Anbu-00001/ConcriSense/ConcreSense_Embedded_Programming_Report.docx

# EMBEDDED PROGRAMMING PROJECT REPORT

Project: ConcreSense: IoT-Based Concrete Quality Verification System
Name: Anbuchelvan Ganesan
Roll No: 24CS0059
Class: CSE - A
Subject: Embedded Programming

# 1. Abstract

ConcreSense is a portable ESP32-based embedded IoT system designed to verify fresh concrete quality directly at construction sites. The device combines a load cell, capacitive moisture sensor, DS18B20 temperature sensor and MPU6050 vibration sensor to capture multiple physical characteristics of a concrete sample. Sensor fusion data is processed using a TinyML model deployed on the ESP32 through Edge Impulse to classify the concrete as GOOD, MARGINAL or REJECT. A NEO-6M GPS module tags every test with location and timestamp, while Wi-Fi/MQTT uploads the results to a cloud dashboard for monitoring, reporting and audit. The proposed solution reduces dependence on laboratory testing, helps detect material fraud, and provides affordable real-time quality verification for civil engineering projects.

## Keywords

ESP32, TinyML, Edge Impulse, Concrete Quality, IoT, Sensor Fusion, GPS, MQTT, Embedded Systems, Construction Monitoring

# 2. Physical Design

The system is built around an ESP32 development board powered by a rechargeable 3.7V Li-ion battery with charging circuitry. A load cell with HX711 amplifier measures load/slump characteristics, a capacitive moisture sensor estimates water content, a DS18B20 measures temperature, and an MPU6050 captures vibration and motion. A NEO-6M GPS module provides location data while a 0.96-inch SSD1306 OLED displays the classification result. The ESP32 communicates with a cloud dashboard through Wi-Fi using MQTT. All modules are integrated inside a portable IP54 enclosure suitable for field use.

## Hardware Architecture

Component | Purpose
ESP32 | Main controller and TinyML inference
HX711 + Load Cell | Concrete load/slump sensing
Capacitive Moisture Sensor | Water content estimation
DS18B20 | Temperature measurement
MPU6050 | Vibration/motion sensing
NEO-6M GPS | Location and timestamp
SSD1306 OLED | Display result
Wi-Fi/MQTT | Cloud communication

# 3. Logical Design

1. Initialize ESP32 and all sensors.
2. Acquire sensor readings from load cell, moisture, temperature and MPU6050.
3. Perform preprocessing and feature extraction.
4. Execute TinyML inference using the Edge Impulse model.
5. Classify the sample as GOOD, MARGINAL or REJECT.
6. Read GPS coordinates and timestamp.
7. Display the result on OLED.
8. Publish JSON data to the cloud dashboard via MQTT.
9. Store test history for monitoring and reporting.

# 4. Circuit Design

The ESP32 acts as the central controller. HX711 interfaces with the load cell using digital data and clock pins. The moisture sensor connects to an ADC pin. DS18B20 communicates through the OneWire interface with a pull-up resistor. MPU6050 communicates over I2C (SDA/SCL). The GPS module uses UART communication, while the OLED display shares the I2C bus. Power is supplied from the Li-ion battery through a charging/protection module to the ESP32 and peripherals. All modules share a common ground for reliable operation.

## Suggested GPIO Connections

Module | ESP32 Interface | Example Pins
HX711 | Digital | GPIO18, GPIO19
Moisture Sensor | ADC | GPIO34
DS18B20 | OneWire | GPIO4
MPU6050 | I2C | GPIO21(SDA), GPIO22(SCL)
NEO-6M GPS | UART | GPIO16(RX), GPIO17(TX)
OLED SSD1306 | I2C | GPIO21, GPIO22

Note: GPIO assignments may be modified depending on the ESP32 development board used.
