Anbu-00001/ConcriSense/ConcreSense_Review0 (3).pptx

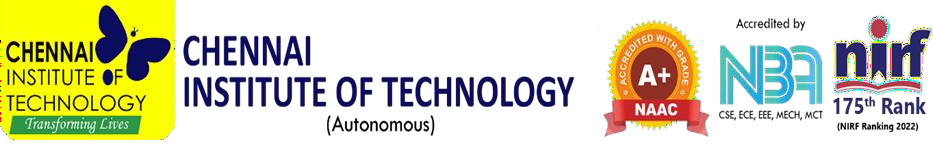
[picture p1: figure]

Department of Computer Science and Engineering
EMBEDDED PROGRAMMING

ConcreSense: IoT-Based Concrete Quality Verification System

Presentation by: [Student Name(s)] | [Roll No.] | [Year & Section]

Supervisor: Dr. [Faculty Name], Dept. of CSE

EMBEDDED PROGRAMMING PROJECT-ZEROTH REVIEW

## CONTENTS

I. Introduction
II. Problem Statement
III. Project Description
IV. Aim and Scope of the Proposed work
V. Literature Survey
VI. Hardware Component
VII. Block Diagram Design
VIII. Project Planning

## Introduction

- Background
- Concrete is the most widely used construction material worldwide, forming the backbone of infrastructure projects ranging from bridges and dams to residential buildings.
- The Problem
- Material fraud involving substandard or adulterated concrete is a persistent challenge in construction, leading to structural failures and safety hazards. Traditional quality testing methods are lab-based, slow, and easy to manipulate.
- Our Solution: ConcreSense
- ConcreSense is a low-cost, portable IoT device powered by the ESP32 microcontroller. It uses an array of sensors and an on-device TinyML model to instantly assess concrete quality at the construction site, GPS-tag each test, and push results to a secure cloud dashboard — making material fraud detectable in real time.
- Key Technologies
- ESP32 Microcontroller | TinyML (Edge Impulse SDK) | Sensor Fusion | NEO-6M GPS | MQTT / Wi-Fi | Cloud Dashboard

## Problem Statement

- Construction quality fraud and the absence of real-time concrete verification pose serious risks to structural safety and public infrastructure. Existing solutions fail to provide immediate, tamper-proof, on-site testing at low cost.
- Key Challenges
- Delayed Testing: Conventional cube strength tests take 7 to 28 days in a laboratory, providing no real-time feedback during active pours.
- Material Fraud: Substandard concrete — with incorrect water-cement ratios, added impurities, or inadequate mixing — is routinely supplied without detection.
- No Location Traceability: Current inspection records lack GPS-verified timestamps, making it impossible to audit which batch was used at which site location.
- High Equipment Cost: Professional concrete analyzers cost ₹50,000 to ₹5,00,000, making them inaccessible to small and mid-scale contractors.
- Need
- An affordable, embedded IoT system capable of real-time concrete quality classification, GPS tagging, and secure cloud reporting — deployable by any site engineer without laboratory infrastructure.

## Project Description

- ConcreSense is a portable, battery-powered IoT device that performs instant on-site concrete quality verification using sensor fusion and TinyML inference — without any laboratory infrastructure.
- How It Works
- Sense: Multi-sensor array (load cell, moisture, temperature, accelerometer) captures fresh concrete properties in under 60 seconds.
- Classify: On-device TinyML model (trained via Edge Impulse) classifies the batch as GOOD, MARGINAL, or REJECT based on IS 456:2000 parameters.
- Tag: NEO-6M GPS module appends geographic coordinates and UTC timestamp to every test result.
- Report: Results are shown on an OLED display and transmitted via Wi-Fi (MQTT) to a secure cloud dashboard with real-time alerts, test history maps, and PDF export.
- Target Cost: Under ₹5,000 per unit | Target Classification Accuracy: ≥ 90%

## Aim and Scope of the Proposed work

- Aim
- To design, develop, and validate an embedded IoT system (ConcreSense) that performs real-time, on-site concrete quality verification using TinyML on the ESP32 and delivers GPS-tagged results to a secure cloud dashboard to detect and prevent material fraud in construction.
- Scope of Work
- Hardware: Integrate load cell, capacitive moisture, temperature, and vibration sensors with ESP32 and GPS module into a portable, IP-rated enclosure.
- Machine Learning: Train and deploy a TinyML classification model on the ESP32 using Edge Impulse, targeting ≥ 90% accuracy across Good, Marginal, and Reject categories.
- Cloud Integration: Build an MQTT-connected dashboard for real-time alerts, geo-mapped test history, and report export; compliant with IS 456:2000 quality benchmarks.
- Future Scope
- Ultrasonic pulse velocity testing for hardened concrete | Blockchain-backed immutable audit trail | Multi-site fleet management portal

## Literature Survey

- [1] Nasr et al. (2021) — CNN for Concrete Crack Detection
- Achieved ~92% accuracy detecting cracks using image-based CNNs. Limitation: only addresses hardened concrete defects; cannot assess fresh concrete quality or fraud.
- [2] Cha et al. (2019) — Deep Learning for Structural Defect Detection
- Demonstrated TinyML feasibility on ARM Cortex-M edge devices for structural monitoring. Validated that lightweight neural networks can run inference on microcontrollers at low power.
- [3] ESP32-Based IoT for Construction Monitoring (2022)
- Real-time temperature and humidity monitoring during concrete curing using ESP32. Useful precedent but limited to environmental parameters; no quality classification or fraud detection.
- [4] Edge Impulse / TinyML Research (2023)
- Sensor-fusion TinyML models for construction material classification on edge devices achieved 88% accuracy. Confirms viability of on-device inference without cloud dependency.
- Research Gap
- No existing system combines multi-sensor fusion, on-device TinyML classification, GPS traceability, and a secure cloud dashboard in a single affordable device for fresh concrete quality verification at the pour site.

## Hardware Component

- ESP32 Development Board — Main microcontroller; dual-core 240 MHz, built-in Wi-Fi and Bluetooth, 520 KB SRAM for TinyML inference.
- Load Cell + HX711 Amplifier — Measures compressive force and slump consistency of fresh concrete mix.
- Capacitive Moisture Sensor (FC-28) — Detects water-cement ratio anomalies (excess water weakens concrete strength).
- DS18B20 Temperature Sensor — Monitors concrete mix temperature; extreme temps affect curing and final strength.
- MPU-6050 (Accelerometer / Gyroscope) — Captures vibration signatures during mixing to detect segregation or air voids.
- NEO-6M GPS Module — Geo-tags every test with latitude, longitude, and UTC timestamp for audit traceability.
- OLED Display (SSD1306, 0.96”) — On-device display of classification result (GOOD / MARGINAL / REJECT) for field engineer.
- Li-Ion Battery Pack (3.7 V, 5000 mAh) + TP4056 Charger — Enables full-day field operation without mains power.
- 3D-Printed IP54-Rated Enclosure — Dust and splash resistant housing designed for rugged construction site conditions.

## Block Diagram Design

- The ConcreSense system follows a three-layer IoT architecture — Sensing, Processing, and Communication — all hosted on the ESP32.
- Layer 1 — Sensor Layer (Inputs)
- Load Cell (HX711) → ESP32 GPIO | Moisture Sensor → ESP32 ADC | DS18B20 → OneWire Bus | MPU-6050 → I²C Bus | NEO-6M GPS → UART
- Layer 2 — Processing Layer (ESP32 Core)
- Raw sensor data is pre-processed (normalization, feature extraction) by ESP32 Core 0. Core 1 runs the TinyML inference engine (Edge Impulse SDK) to classify the batch as GOOD, MARGINAL, or REJECT. GPS coordinates and timestamp are appended to the result payload.
- Layer 3 — Communication and Display Layer (Outputs)
- OLED Display: Immediate on-screen result for field engineer. Wi-Fi / MQTT: JSON payload transmitted to cloud broker (e.g., HiveMQ / AWS IoT). Dashboard: React-based web portal renders live map, result history, trend charts, and PDF export. Alert System: Automated email / SMS alert on REJECT classification.
- Full cycle — sensor read to cloud update: < 5 seconds

## Project Planning

- The project is planned over 12 weeks from component procurement to final demonstration and documentation.
- Week 1–2: Component Procurement and Hardware Setup
- Source ESP32, sensors, GPS module, display, and enclosure materials. Verify component specifications and set up development environment (Arduino IDE / PlatformIO, Edge Impulse).
- Week 3–4: Sensor Integration and Data Acquisition
- Interface all sensors with ESP32. Validate data readings against known concrete mixes. Build data logging pipeline for ML dataset collection.
- Week 5–6: Dataset Collection and Labelling
- Prepare concrete batches of varying quality (correct mix, excess water, sand substitution). Collect 200+ labelled sensor readings across GOOD, MARGINAL, and REJECT classes.
- Week 7–8: TinyML Model Training and Deployment
- Train classification model on Edge Impulse. Optimize for ESP32 SRAM constraints. Deploy quantized model to ESP32 firmware and test inference accuracy on holdout data.
- Week 9–10: GPS, Wi-Fi, Cloud Dashboard Integration
- Integrate GPS module, implement MQTT transmission, and build cloud dashboard with map view, history log, alerts, and PDF export.
- Week 11: Field Testing and Calibration
- Conduct field trials at a simulated construction site. Calibrate sensors, validate GPS accuracy, and stress-test the enclosure. Cross-check results against IS 456:2000 benchmarks.
- Week 12: Documentation and Final Review Presentation
- Complete project report, circuit diagrams, and code documentation. Prepare and deliver final demonstration to review panel.
