Anbu-00001/ConcriSense/tinyml_model/eval_output/confusion_matrix.png

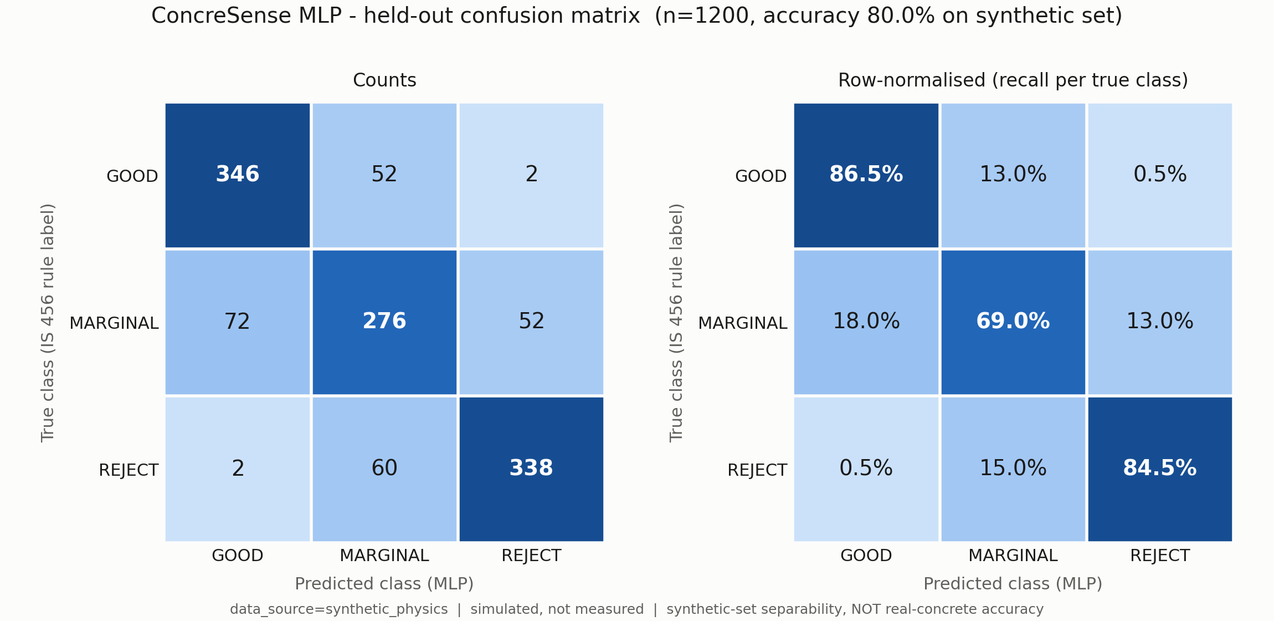
tinyml_model/eval_output/confusion_matrix.png
