Anbu-00001/ConcriSense/firmware/concresense/src/config.h

// ConcreSense — central hardware configuration
//
// Board verified over USB on 2026-08-04:
//   ESP32-D0WD-V3 rev v3.1 | dual core 240MHz | 4MB flash | no PSRAM
//   MAC c0:cd:d6:ce:4a:50  | "Vref calibration in eFuse" present
//
// The eFuse Vref matters: it lets analogReadMilliVolts() return a properly
// calibrated voltage instead of assuming a nominal 1100mV reference that can
// really be anywhere from 1000-1200mV part to part.
//
// No PSRAM matters too: GPIO16/17 are only free for UART2 because this is a
// WROOM. On a WROVER those pins belong to the PSRAM and the GPS dies silently.

#pragma once
#include <Arduino.h>

// ---------------------------------------------------------------- identity
#define DEVICE_ID "CONCRESENSE_ESP32_001"
#define FW_VERSION "0.5.0-phase5"
#define COMPLIANCE_STANDARD "IS 456:2000"

// Submission identity. Kept here rather than inline in the sketch so it appears
// in exactly one place -- it is printed on the serial banner and the OLED
// splash, and duplicating string literals across both is how they drift apart.
#define STUDENT_NAME "Anbuchelvan"
#define STUDENT_SECTION "CSE A"
#define STUDENT_ROLL "24CS0059"

// ------------------------------------------------------------------- pins
// I2C bus 0 — shared by SSD1306 OLED and MPU-6050 (distinct addresses)
#define PIN_I2C_SDA 21
#define PIN_I2C_SCL 22
#define I2C_FREQ_HZ 400000UL  // 400kHz: the 128x64 frame push is ~1KB, and at
                              // 100kHz it would stall IMU sampling badly

#define ADDR_SSD1306 0x3C
#define ADDR_MPU6050 0x68  // 0x69 if AD0 is strapped high

// Capacitive soil-moisture sensor v1.2 -> ADC1 (input-only pin, no pull-ups)
//
// NOTE: the project docs call this an "FC-28". That is wrong and it matters.
// FC-28 is the RESISTIVE two-prong module; it measures ionic conductivity,
// corrodes within minutes in cement pore solution, and is NOT described by the
// Lichtenecker dielectric model the docs cite. Use the capacitive v1.2 board.
#define PIN_MOISTURE_AOUT 34

// HX711 load cell amplifier (bit-banged 2-wire protocol)
#define PIN_HX711_DOUT 18
#define PIN_HX711_SCK 19

// DS18B20 on OneWire — needs an external 4.7k pull-up to 3V3
#define PIN_DS18B20_DQ 4

// NEO-6M GPS on hardware UART2
#define PIN_GPS_RX 16  // ESP32 receives  <- GPS TX
#define PIN_GPS_TX 17  // ESP32 transmits -> GPS RX
#define GPS_BAUD 9600

// ---------------------------------------------------------------- ADC setup
// The capacitive v1.2 sensor swings roughly 1.0V (wet) to 3.0V (dry).
// ESP32's default 0dB attenuation saturates at ~1.1V, which would rail almost
// the entire useful range to 4095. 11dB (12dB on newer cores) gives ~0-3.1V.
#define MOISTURE_ADC_ATTEN ADC_11db
#define MOISTURE_ADC_SAMPLES 64  // averaged to suppress ESP32 ADC noise

// ---------------------------------------------------------------- HX711
// Datasheet constraint: holding SCK high for >60us puts the HX711 into power
// down mode. Under FreeRTOS a task switch mid-read does exactly that, which is
// why the read is wrapped in a portMUX critical section.
#define HX711_READ_TIMEOUT_MS 600  // widened from 200: the post-reset settle
                                   // to the first ready conversion sometimes
                                   // ran close to the old margin on this board
#define HX711_SCK_SETTLE_US 1  // ESP32 at 240MHz toggles faster than the
                               // HX711's minimum clock high/low time

// Placeholder — overwritten by the tare/calibration routine in Phase 2.
#define HX711_DEFAULT_SCALE 1.0f

// Plausibility ceiling for read(), in raw counts against the last accepted
// reading. Originally tuned tight (6000) against a quiet idle noise floor of
// tens of counts. That assumption broke the moment real presses started:
// pressing the plunger IS a real, large, legitimate single-cycle jump, and
// the tight gate was rejecting it as OUT_OF_RANGE -- indistinguishable from
// corruption at that threshold. The idle floor itself also reads noisier at
// this venue (hundreds to ~1500 counts, not tens). Widened well above both,
// so this now only catches genuinely impossible spikes (multi-order-of-
// magnitude, e.g. the +677699 outlier seen earlier) rather than real force
// or venue noise. Loosening this trades away catching the smaller (8000-
// 24000 count) corruption clusters seen before -- acceptable: a live device
// that ignores real presses is a worse failure than one that occasionally
// shows a noisy number.
#define HX711_MAX_PLAUSIBLE_JUMP 200000.0f

// A pure "reject if far from last accepted value" gate has no way back if
// the true resting value genuinely moves and does not drift back to the old
// baseline -- observed directly on this board: after one such shift, EVERY
// following reading was rejected forever, the load cell going permanently
// static/blank on the OLED and dashboard, which is worse than the garbage
// values the gate was built to stop. After this many consecutive rejections
// the latest reading is accepted as a new baseline instead of staying stuck.
#define HX711_MAX_REJECT_STREAK 3

// ---------------------------------------------------------------- IMU
#define IMU_SAMPLE_RATE_HZ 200
#define IMU_BURST_SAMPLES 256  // power of two, required by the radix-2 FFT
                               // 256 @ 200Hz = 1.28s window, 0.78Hz bin width

// ---------------------------------------------------------------- core split
//
// The project docs assign sensors to Core 0 and networking to Core 1. That is
// backwards: on Arduino-ESP32 the Wi-Fi and TCP/IP stacks are pinned to Core 0
// by default. Following the docs would put 200Hz IMU sampling and a 60us-
// critical HX711 read on the same core as the Wi-Fi driver, turning every
// beacon and TCP retransmit into sample jitter and corrupted weight readings.
//
// So: timing-critical sampling on Core 1, jitter-tolerant inference and
// networking on Core 0 alongside the Wi-Fi stack already living there.
// Phase 1 is single-threaded; these take effect when tasks are created.
#define CORE_SAMPLING 1
#define CORE_INFERENCE_NET 0

// Interval between automatic measurement cycles when auto-mode is armed ('a').
// 5s is a deliberate choice: an IMU burst alone is 1.28s, and fresh concrete
// properties change over minutes, not milliseconds -- sampling faster would
// only heat the board and flood the broker.
#define MEASURE_INTERVAL_MS 5000

// ---------------------------------------------------------------- bring-up
#define SERIAL_BAUD 115200
#define BRINGUP_I2C_SCAN true
