Anbu-00001/ConcriSense/(commit log)

2026-08-04 Initial commit: ConcriSense firmware, physics, features, and documentation
    [dataset.csv]
2026-08-04 Update tinyml_model dataset generator with stratified sampling
    [dataset.csv]
2026-08-04 Add calibration subsystem, interactive REPL, host test harness, and sensor fixes
    - firmware/concresense.ino: add calibrateMoisture(), calibrateLoadCell(),
    handleCommand(), printCalState(), printHelp() interactive REPL commands
    (m/c/cm/cl/s/x/h); load anchors at setup() before sensor init; add
    OUT_OF_RANGE branch for HX711 railed-reading fault diagnosis
    - physics/anchors_store.{h,cpp}: new NVS-backed calibration store for
    moisture (dry/sat mV, ref temp) and load-cell (counts/N, plunger area)
    anchors; anchors::load(), anchors::saveLoadCell(), anchors::clear()
    - sensors/moisture_cap.cpp: switch presence detection from millivolts to
    raw ADC counts; fix silent-garbage failure where ES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
    [anchors_store.cpp, anchors_store.h, concresense.ino, gps_neo6m.cpp, gps_neo6m.h, moisture_cap.cpp, monitor.py]
2026-08-04 Add Phase 1/2 report, calibration struct fixes, dataset update, and CLAUDE notes
    - PHASE_1_2_REPORT.md: full Phase 1 & 2 progress report covering firmware
    bring-up, sensor validation, calibration subsystem, host test harness,
    and dataset generation status
    - CLAUDE.md: update project notes with calibration workflow and REPL usage
    - physics/calibration.h: struct and constant fixes
    - sensors/loadcell_hx711.cpp: refine HX711 read and out-of-range handling
    - tinyml_model/dataset.csv + dataset.meta.json: updated synthetic dataset
    [dataset.csv]
2026-08-05 feat: add simulation module, physics model, and wokwi diagram
    - Updated firmware/concresense/concresense.ino with latest sensor logic
    - Added tinyml_model/concresense_physics.py for physics-based data generation
    - Expanded tinyml_model/dataset.csv and dataset.meta.json with new synthetic samples
    - Refactored tinyml_model/dataset_generator.py with improved generation pipeline
    - Added simulation/concresense_sim.py and simulation/README.md
    - Added wokwi/diagram.json for circuit simulation reference
    - Updated .gitignore: exclude simulation/out/ and common video formats (mp4/avi/mov)
    [dataset.csv]
2026-08-10 docs: add comprehensive README, wiring diagram prompts, and SVG diagram
2026-08-11 feat: enhance dashboard UI, update OLED display driver, and add presentation notes
2026-08-11 fix: update dashboard UI, improve PDF report, and adjust firmware config
    [config.h]
2026-08-11 feat: add live dashboard page, enhance sensor drivers (GPS, load cell), and update display/network modules
2026-08-11 refactor: improve main firmware loop, extend load cell driver, and update config/measurement structs
2026-08-12 refactor: update config structs, enhance OLED display, extend GPS/load cell sensor drivers
2026-10-03 feat: add 6000-row synthetic training set, generator, and confusion-matrix evaluation
    [confusion_matrix.csv, trainingdata.csv]
